DrCaH4ec/Tube-amplifier/README.md

# Tube-amplifier
Course work on the subject of analog electronics
