DrCaH4ec/Tube-amplifier/Scheme/SCHEME.JPG

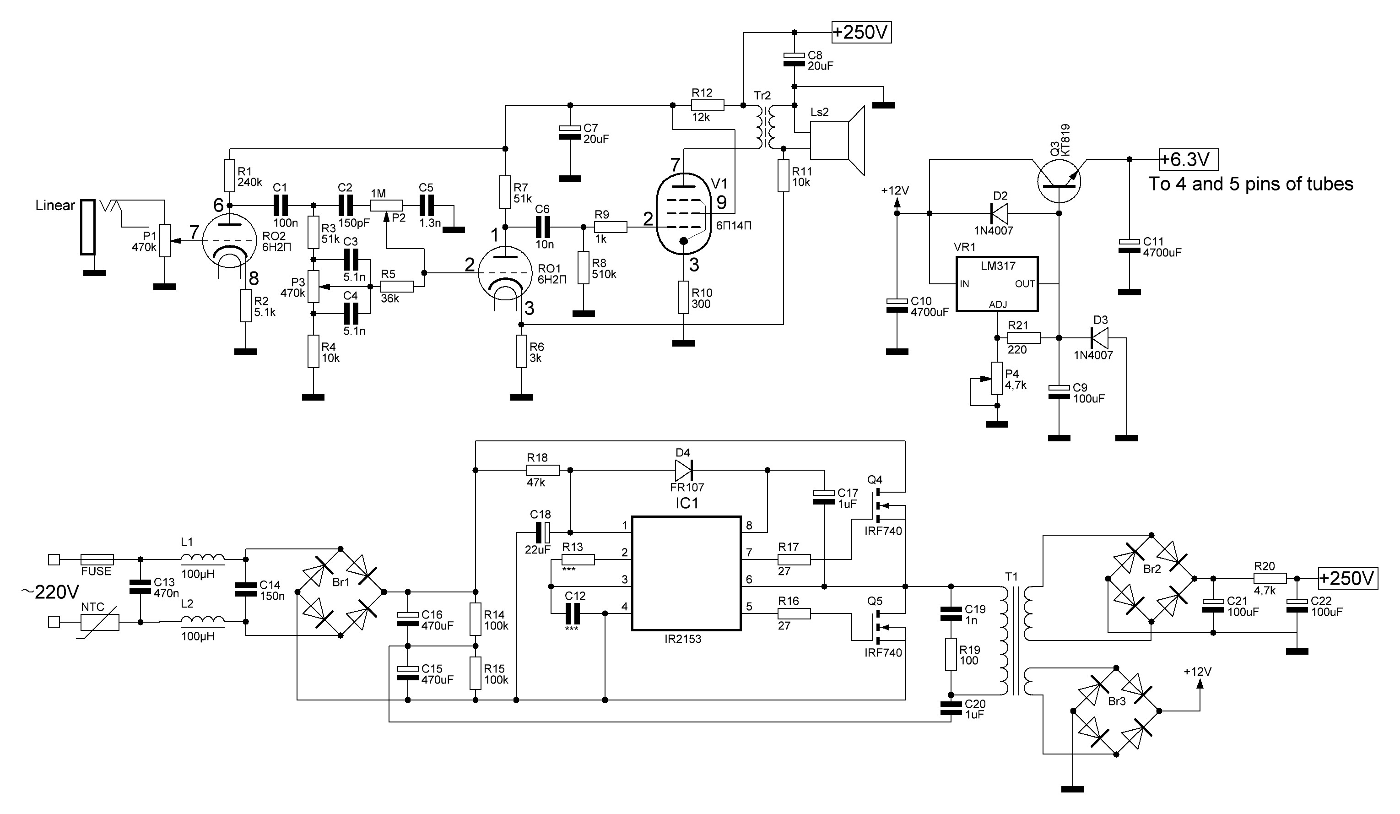
Scheme/SCHEME.JPG
