DrCaH4ec/Tube-amplifier/(list of files, drawings)

Other design files:
PCB.lay6
Scheme/SCHEME.spl7
